Kaitoukid93/Ambino-Fan-HUB/Packaging/Huong dan lap dat.pdf

# 1 Kết Nối Fan

Hướng dẫn này chỉ áp dụng cho sản phẩm Ambino FAN HUB
Các hình dạng và thành phần của sản phẩm có thể thay đổi mà không báo trước

Cắm lần lượt các Fan vào vị trí các cổng theo số bên dưới. Fan không cần cắm theo thứ tự nhưng nếu các bạn nhớ được thứ tự Fan thì sẽ tốt hơn trong việc căn chỉnh hiệu ứng

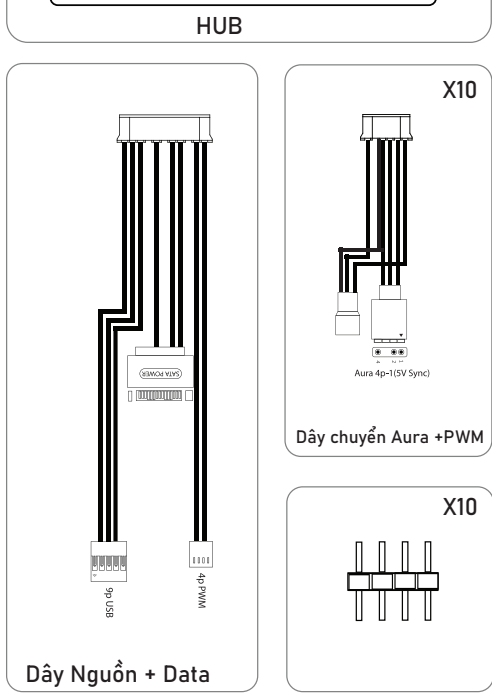
[picture p1: figure]
HUB; Dây Nguồn + Data; Dây chuyển Aura +PWM

Đối với các Fan sử dụng cổng Aura 5V và cổng PWM thì các bạn cần cắm qua dây chuyển trước rồi sau đó mới cắm vào hub

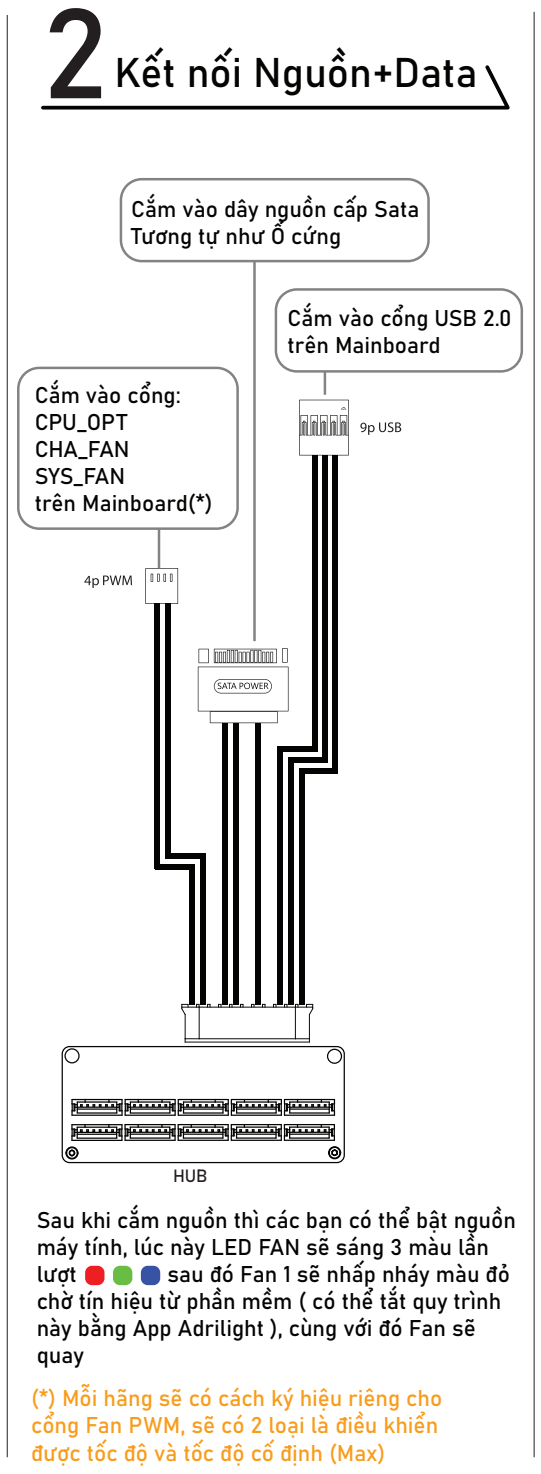
[picture p2: figure]
lượt; sau đó Fan 1 sẽ nhấp nháy màu đỏ; quay; Cắm vào dây nguồn cấp Sata Tương tự như Ổ cứng; Cắm vào cổng USB 2.0 trên Mainboard; Cắm vào cổng: CPU_OPT CHA_FAN SYS_FAN trên Mainboard(*); được tốc độ và tốc độ cố định (Max); 2 Kết nối Nguồn+Data; HUB

Sau khi cắm nguồn thì các bạn có thể bật nguồn máy tính, lúc này LED FAN sẽ sáng 3 màu lần chờ tín hiệu từ phần mềm ( có thể tắt quy trình này bằng App Adrilight ), cùng với đó Fan sẽ

(*) Mỗi hãng sẽ có cách ký hiệu riêng cho cổng Fan PWM, sẽ có 2 loại là điều khiển

# Hướng dẫn sử dụng

1 | 3 | 5 | 7 | 9
2 | 4 | 6 | 8 | 10

Dây chuyển Aura +PWM

Dây chuyển (nếu có)

Fan1 | Fan10

Truy cập Website http://ambino.vn để tải phần mềm.

0976.08.03.06

# 3Cài đặt phần mềm

DOWNLOAD

Double click file Setup.exe để cài đặt.

Chọn để thêm sản phẩm

Chọn sản phẩm Ambino Fan Hub

Chọn thông số rồi nhấn Finish

Click vào thẻ để
điều chỉnh các hiệu
ứng theo ý muốn

Nút này sẽ tự động
bật xanh

Thêm mới

Dashboard

Ambino Fan Hub
COM3
Device ID : 1
Độ sáng : 80%

Ẩn
