Kaitoukid93/Ambino-Fan-HUB/2D Resource/Untitled.dxf

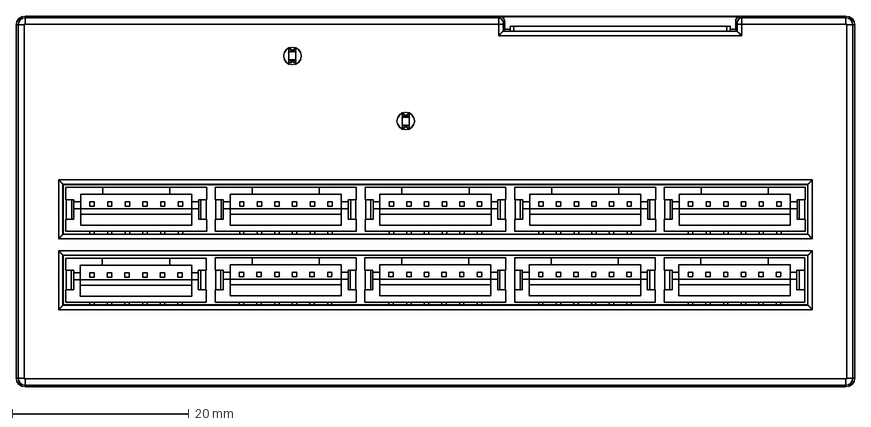
[picture p3: CAD file, 2022-07-25]
2D Resource/Untitled.dxf
95.0 x 42.0 mm
