Kaitoukid93/Ambino-Fan-HUB/Hardware/Ambino Fan HUB CH552G(Developer Only) rev2 dual core/exported outline.dxf

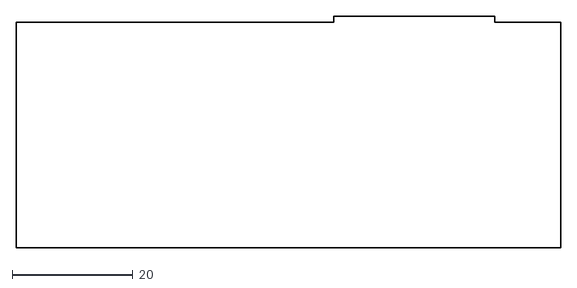
[picture p4: CAD file, 2022-01-03]
Hardware/Ambino Fan HUB CH552G(Developer Only) rev2 dual core/exported outline.dxf
90.2 x 38.4
