Kaitoukid93/Ambino-Fan-HUB/2D Resource/finished enclosure.dxf

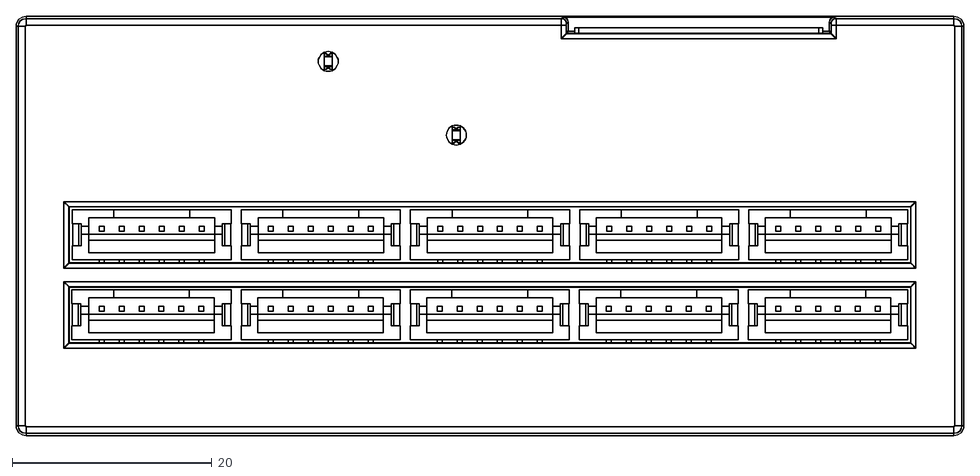
[picture p5: CAD file, 2022-07-25]
2D Resource/finished enclosure.dxf
95.0 x 42.0
