Kaitoukid93/Ambino-Fan-HUB/Hardware/Ambino Fan HUB CH552G(Developer Only) rev2 dual core/fanhub freecad.FCStd

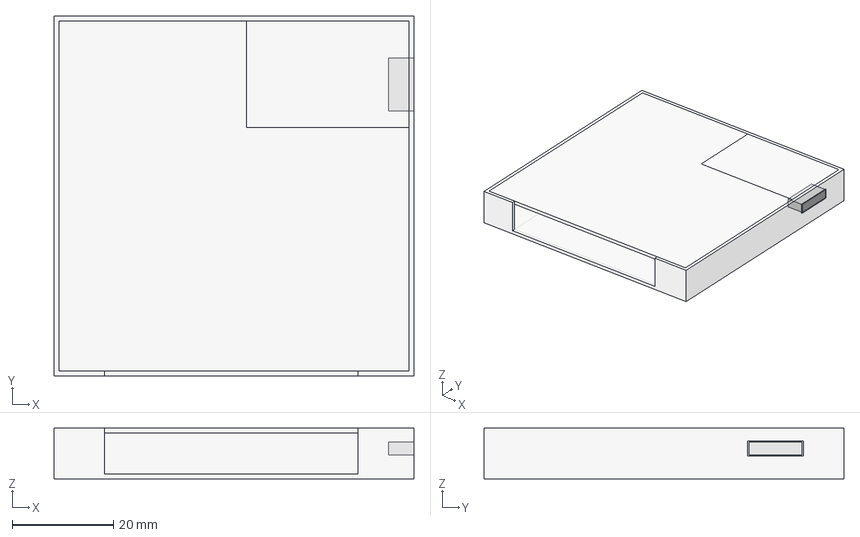
[picture p6: CAD file, 2021-12-10]
Hardware/Ambino Fan HUB CH552G(Developer Only) rev2 dual core/fanhub freecad.FCStd
71.0 x 71.0 x 10.0 mm
