Kaitoukid93/Ambino-Fan-HUB/2D Resource/outline.dxf

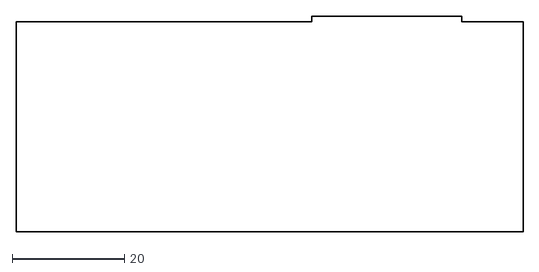
[picture p7: CAD file, 2022-01-03]
2D Resource/outline.dxf
90.2 x 38.4
