Kaitoukid93/Ambino-Fan-HUB/Hardware/Ambino Fan HUB CH552G(Developer Only) rev2 dual core/demo2.FCStd

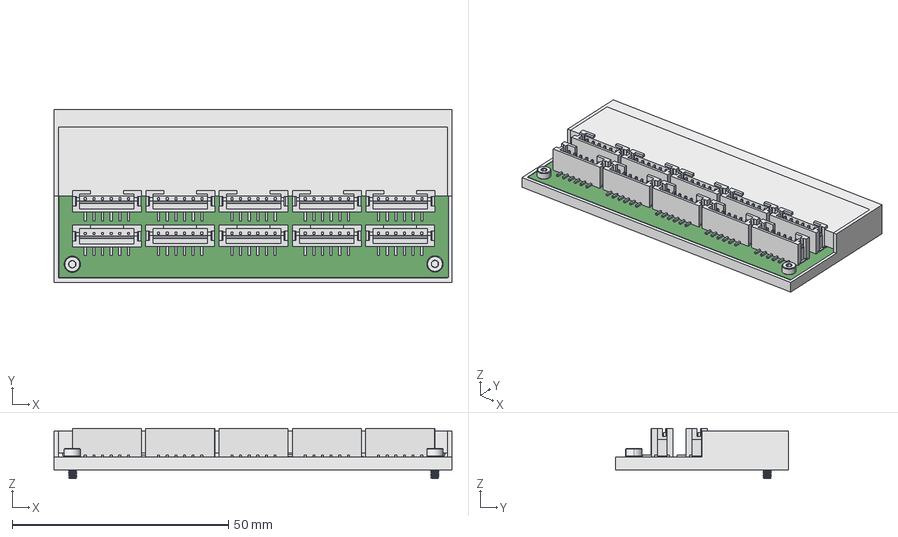
[picture p8: CAD file, 2021-12-10]
Hardware/Ambino Fan HUB CH552G(Developer Only) rev2 dual core/demo2.FCStd
92.0 x 40.0 x 11.6 mm
