Kaitoukid93/Ambino-Fan-HUB/2D Resource/drawing.dxf

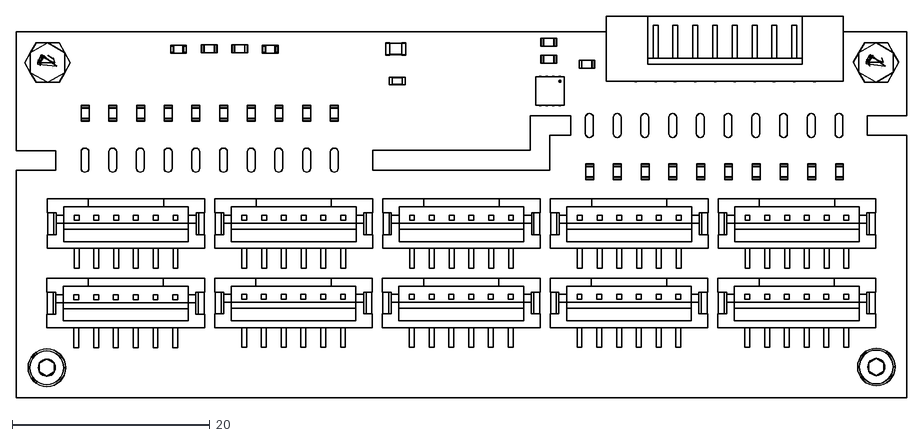
[picture p9: CAD file, 2021-12-31]
2D Resource/drawing.dxf
90.0 x 38.6
