Kaitoukid93/Ambino-Fan-HUB/2D Resource/PH6.dxf

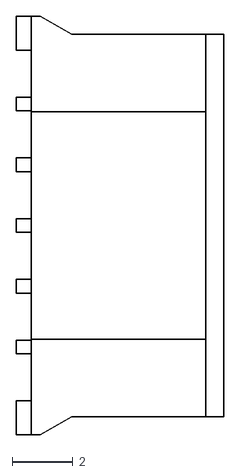
[picture p10: CAD file, 2021-12-10]
2D Resource/PH6.dxf
6.85 x 13.8
