Kaitoukid93/Ambino-Fan-HUB/2D Resource/PH11.dxf

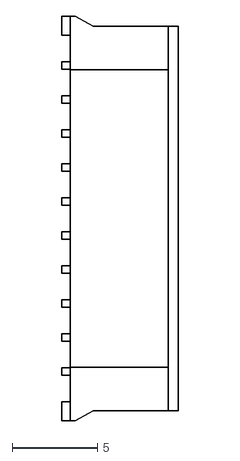
[picture p11: CAD file, 2021-12-10]
2D Resource/PH11.dxf
6.85 x 23.8
