Kaitoukid93/Ambino-Fan-HUB/Hardware/Wire and Connector/Ambino Fan HUB All wire_Fix_PWM.pdf

# Power +USB+PWM cord

# Ambino Fan HUB

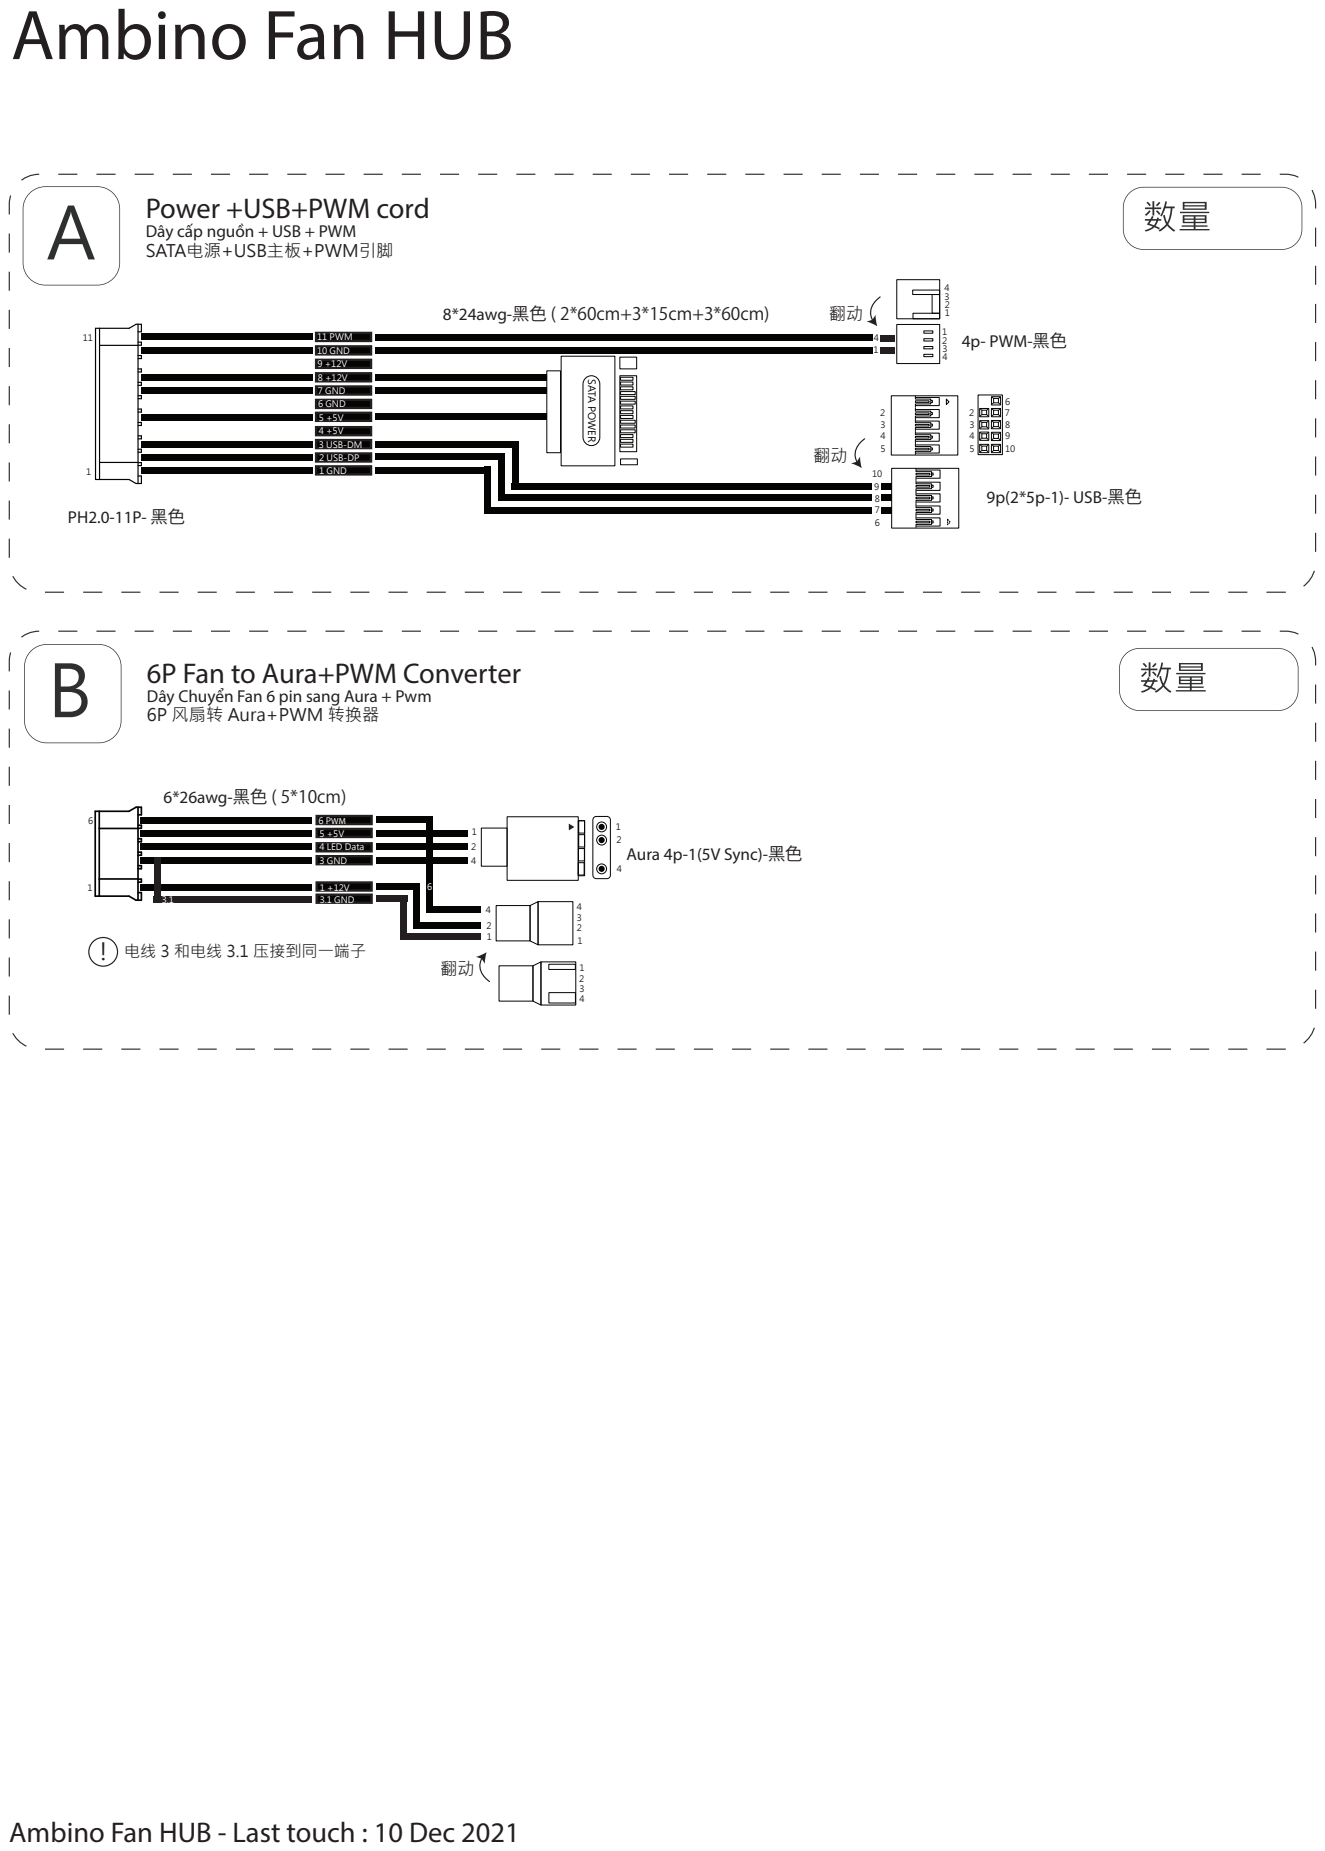
[picture p12: page 1]
10 GND; 4p- PWM-黑色; 8*24awg-黑色 ( 2*60cm+3*15cm+3*60cm); 6*26awg-黑色 ( 5*10cm); Aura 4p-1(5V Sync)-黑色; 9p(2*5p-1)- USB-黑色; 1 GND; 2 USB-DP; 3 USB-DM; 6 GND; 7 GND; 11 PWM; 1 +12V 3.1 GND; 3 GND; 4 LED Data; 6 PWM; SATA POWER

Dây cấp nguồn + USB + PWM
SATA电源+USB主板+PWM引脚

6P Fan to Aura+PWM Converter
Dây Chuyển Fan 6 pin sang Aura + Pwm
6P 风扇转 Aura+PWM 转换器

! 电线 3 和电线 3.1 压接到同一端子

Ambino Fan HUB - Last touch : 10 Dec 2021
