Kaitoukid93/Ambino-Fan-HUB/Packaging/file in tem ambino fan HUB.pdf

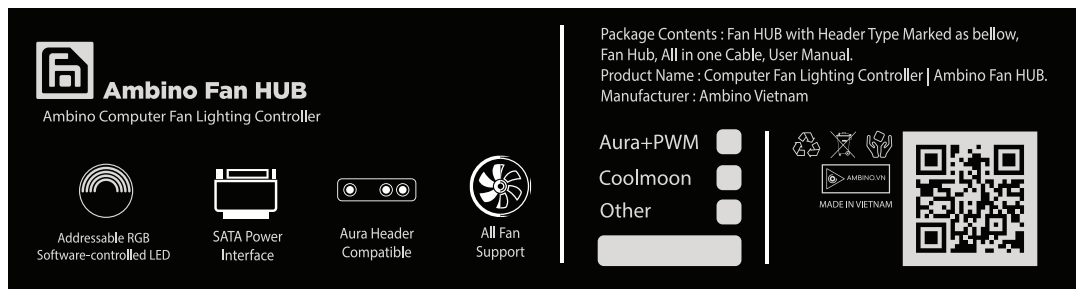
[picture p13: page 1]
