Kaitoukid93/Ambino-Fan-HUB/Hardware/CH552G dualcore/Ambino Fan HUB CH552G.kicad_pcb

## KiCad design Hardware/CH552G dualcore/Ambino Fan HUB CH552G.kicad_pcb (2022-07-25)

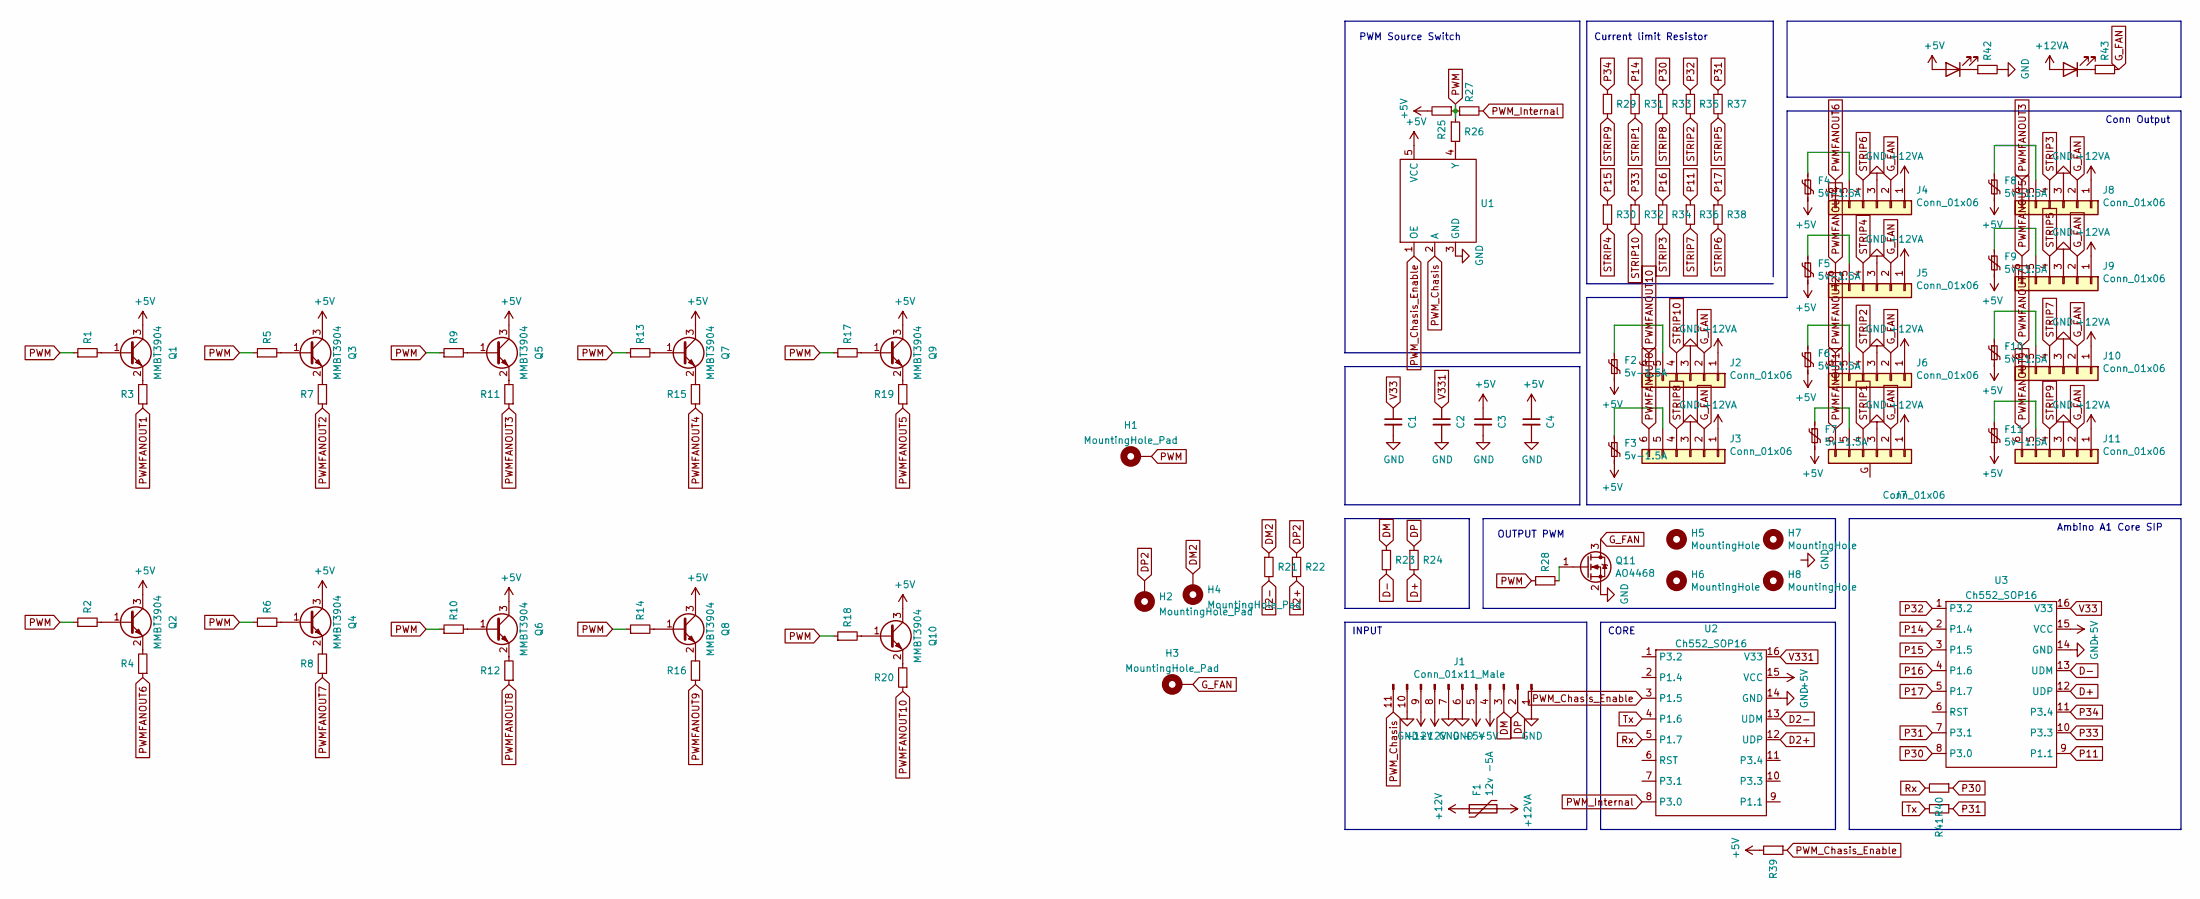
[picture p17: schematic Ambino Fan HUB CH552G.kicad_sch]

Parts:
C1, C2: 104; C_0603_1608Metric
C3, C4: 106; C_0603_1608Metric
D1: LED_BLUE; LED_0603_1608Metric
D2: LED_GREEN; LED_0603_1608Metric
F1: 12v -5A; Fuse_1206_3216Metric
F2, F3, F4, F5, F6, F7, F8, F9, F10, F11: 5v-1.5A; Fuse_0603_1608Metric
H1, H2, H3, H4: MountingHole_Pad; MountingHole_2.2mm_M2_DIN965_Pad
H5, H6, H7, H8: MountingHole; Mounting_Wuerth_WA-SMSI-M2_H1.5mm_9774015243
J1: Conn_01x11_Male; JST_PH_S11B-PH-SM4-TB_1x11-1MP_P2.00mm_Horizontal
J2, J3, J4, J5, J6, J7, J8, J9, J10, J11: Conn_01x06; JST_PH_B6B-PH-K_1x06_P2.00mm_Vertical
Q1, Q2, Q3, Q4, Q5, Q6, Q7, Q8, Q9, Q10: MMBT3904; SOT-23
Q11: AO4468; SOP-8_3.9x4.9mm_P1.27mm
R1, R2, R5, R6, R9, R10, R13, R14, R17, R18, R26, R27, R28: 150R; R_0603_1608Metric
R3, R4, R7, R8, R11, R12, R15, R16, R19, R20, R29, R30, R31, R32, R33, R34, R35, R36, R37, R38, R40, R41: 220R; R_0603_1608Metric
R21, R22, R23, R24: 33R; R_0603_1608Metric
R25, R39: 10k; R_0603_1608Metric
R42: 330R; R_0603_1608Metric
R43: 1K; R_0603_1608Metric
U1: SN74AHC1G125DBVR; SOT-23-5
U2, U3: Ch552_SOP16; SOP-16_3.9x9.9mm_P1.27mm

Connections:
+5V: C3.1, C4.1, D1.2 (A), F2.2, F3.2, F4.2, F5.2, F6.2, F7.2, F8.2, F9.2, F10.2, F11.2, J1.4, J1.5, Q1.3 (C), Q2.3 (C), Q3.3 (C), Q4.3 (C), Q5.3 (C), Q6.3 (C), Q7.3 (C), Q8.3 (C), Q9.3 (C), Q10.3 (C), R25.2, R39.2, U1.5 (VCC), U2.15 (VCC), U3.15 (VCC)
+12V: F1.1, J1.8, J1.9
+12VA: D2.2 (A), F1.2, J2.1, J3.1, J4.1, J5.1, J6.1, J7.1, J8.1, J9.1, J10.1, J11.1
D2+: R22.2, U2.12 (UDP)
D2-: R21.2, U2.13 (UDM)
D+: R24.2, U3.12 (UDP)
D-: R23.2, U3.13 (UDM)
DM: J1.3, R23.1
DM2: H4.1, R21.1; also elsewhere on the board
DP: J1.2, R24.1
DP2: H2.1, R22.1; also elsewhere on the board
GND: C1.2, C2.2, C3.2, C4.2, J1.1, J1.6, J1.7, J1.10, J2.3, J3.3, J4.3, J5.3, J6.3, J7.3, J8.3, J9.3, J10.3, J11.3, Q11.2 (S), R42.2, U1.3 (GND), U2.14 (GND), U3.14 (GND)
G_FAN: H3.1, J2.2, J3.2, J4.2, J5.2, J6.2, J7.2, J8.2, J9.2, J10.2, J11.2, Q11.3 (D), R43.2; also elsewhere on the board
unnamed: D1.1 (K), R42.1
unnamed: D2.1 (K), R43.1
unnamed: F2.1, J2.5
unnamed: F3.1, J3.5
unnamed: F4.1, J4.5
unnamed: F5.1, J5.5
unnamed: F6.1, J6.5
unnamed: F7.1, J7.5
unnamed: F8.1, J8.5
unnamed: F9.1, J9.5
unnamed: F10.1, J10.5
unnamed: F11.1, J11.5
unnamed: Q1.1 (B), R1.2
unnamed: Q1.2 (E), R3.2
unnamed: Q2.1 (B), R2.2
unnamed: Q2.2 (E), R4.2
unnamed: Q3.1 (B), R5.2
unnamed: Q3.2 (E), R7.2
unnamed: Q4.1 (B), R6.2
unnamed: Q4.2 (E), R8.2
unnamed: Q5.1 (B), R9.2
unnamed: Q5.2 (E), R11.2
unnamed: Q6.1 (B), R10.2
unnamed: Q6.2 (E), R12.2
unnamed: Q7.1 (B), R13.2
unnamed: Q7.2 (E), R15.2
unnamed: Q8.1 (B), R14.2
unnamed: Q8.2 (E), R16.2
unnamed: Q9.1 (B), R17.2
unnamed: Q9.2 (E), R19.2
unnamed: Q10.1 (B), R18.2
unnamed: Q10.2 (E), R20.2
unnamed: Q11.1 (G), R28.2
unnamed: R26.2, U1.4 (Y)
P11: R36.1, U3.9 (P1.1)
P14: R31.1, U3.2 (P1.4)
P15: R30.1, U3.3 (P1.5)
P16: R34.1, U3.4 (P1.6)
P17: R38.1, U3.5 (P1.7)
P30: R33.1, R40.1, U3.8 (P3.0)
P31: R37.1, R41.1, U3.7 (P3.1)
P32: R35.1, U3.1 (P3.2)
P33: R32.1, U3.10 (P3.3)
P34: R29.1, U3.11 (P3.4)
PWM: H1.1, R1.1, R2.1, R5.1, R6.1, R9.1, R10.1, R13.1, R14.1, R17.1, R18.1, R25.1, R26.1, R27.1, R28.1; also elsewhere on the board
PWMFANOUT1: J7.6, R3.1
PWMFANOUT2: J6.6, R7.1
PWMFANOUT3: J8.6, R11.1
PWMFANOUT4: J5.6, R15.1
PWMFANOUT5: J9.6, R19.1
PWMFANOUT6: J4.6, R4.1
PWMFANOUT7: J10.6, R8.1
PWMFANOUT8: J3.6, R12.1
PWMFANOUT9: J11.6, R16.1
PWMFANOUT10: J2.6, R20.1
PWM_Chasis: J1.11, U1.2 (A)
PWM_Chasis_Enable: R39.1, U1.1 (OE), U2.3 (P1.5)
PWM_Internal: R27.2, U2.8 (P3.0)
Rx: R40.2, U2.5 (P1.7)
STRIP1: J7.4, R31.2
STRIP2: J6.4, R35.2
STRIP3: J8.4, R34.2
STRIP4: J5.4, R30.2
STRIP5: J9.4, R37.2
STRIP6: J4.4, R38.2
STRIP7: J10.4, R36.2
STRIP8: J3.4, R33.2
STRIP9: J11.4, R29.2
STRIP10: J2.4, R32.2
Tx: R41.2, U2.4 (P1.6)
V33: C1.1, U3.16 (V33)
V331: C2.1, U2.16 (V33)

Notes on the sheet:
Conn Output
Ambino A1 Core SIP
OUTPUT PWM
Current limit Resistor
CORE
INPUT
PWM Source Switch

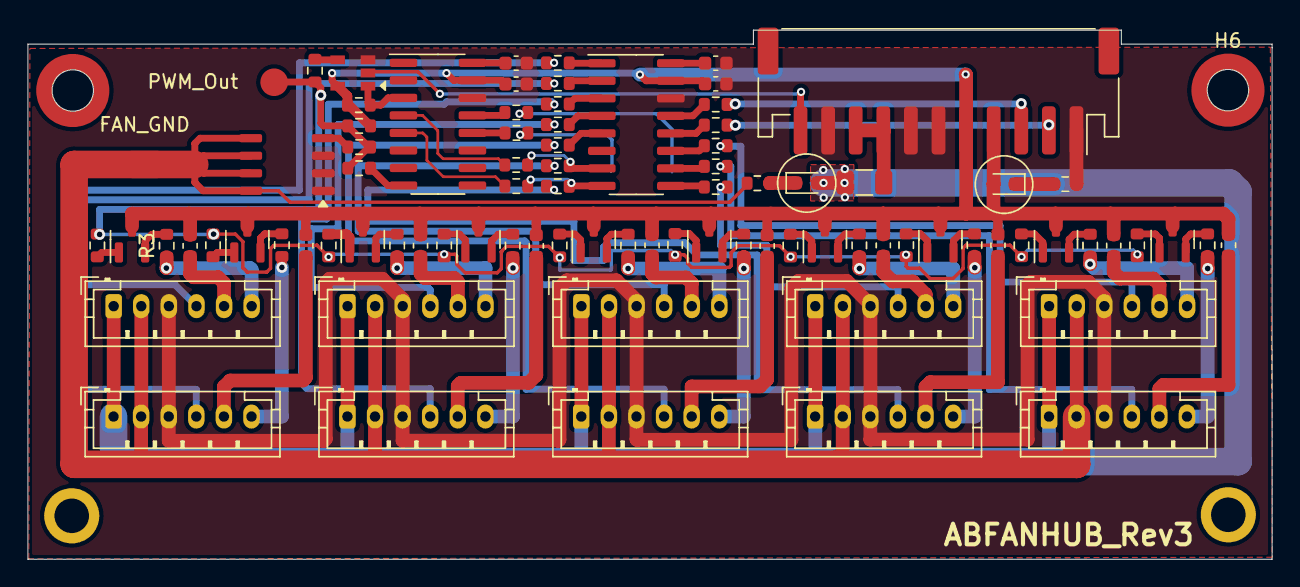
[picture p18: board Hardware/CH552G dualcore/Ambino Fan HUB CH552G.kicad_pcb from above]

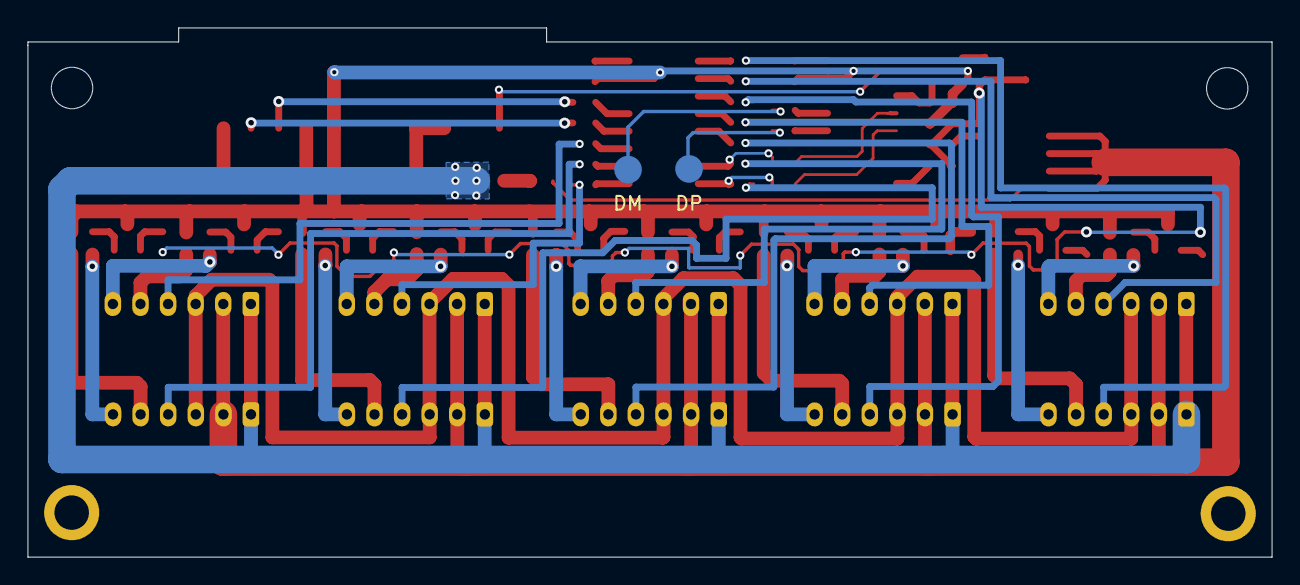
[picture p19: board Hardware/CH552G dualcore/Ambino Fan HUB CH552G.kicad_pcb from below]

Board: 2 copper layers, 90.2 x 38.4 mm, 93 parts (2 on the bottom side), 85 nets.

Other parts of the board:
DM: MountingHole_Pad; MountingHole_2.2mm_M2_DIN965_Pad
DP: MountingHole_Pad; MountingHole_2.2mm_M2_DIN965_Pad
FAN_GND: MountingHole_Pad; MountingHole_2.2mm_M2_DIN965_Pad
PWM_Out: MountingHole_Pad; MountingHole_2.2mm_M2_DIN965_Pad

Their connections:
DM2: DM.1; also elsewhere on the board
DP2: DP.1; also elsewhere on the board
G_FAN: FAN_GND.1; also elsewhere on the board
PWM: PWM_Out.1; also elsewhere on the board
