Kaitoukid93/Ambino-Fan-HUB/Hardware/Ambino Fan HUB CH552G(Developer Only) rev2 dual core/Ambino Fan HUB CH552G.kicad_pcb

## KiCad design Hardware/Ambino Fan HUB CH552G(Developer Only) rev2 dual core/Ambino Fan HUB CH552G.kicad_pcb (2022-01-03)

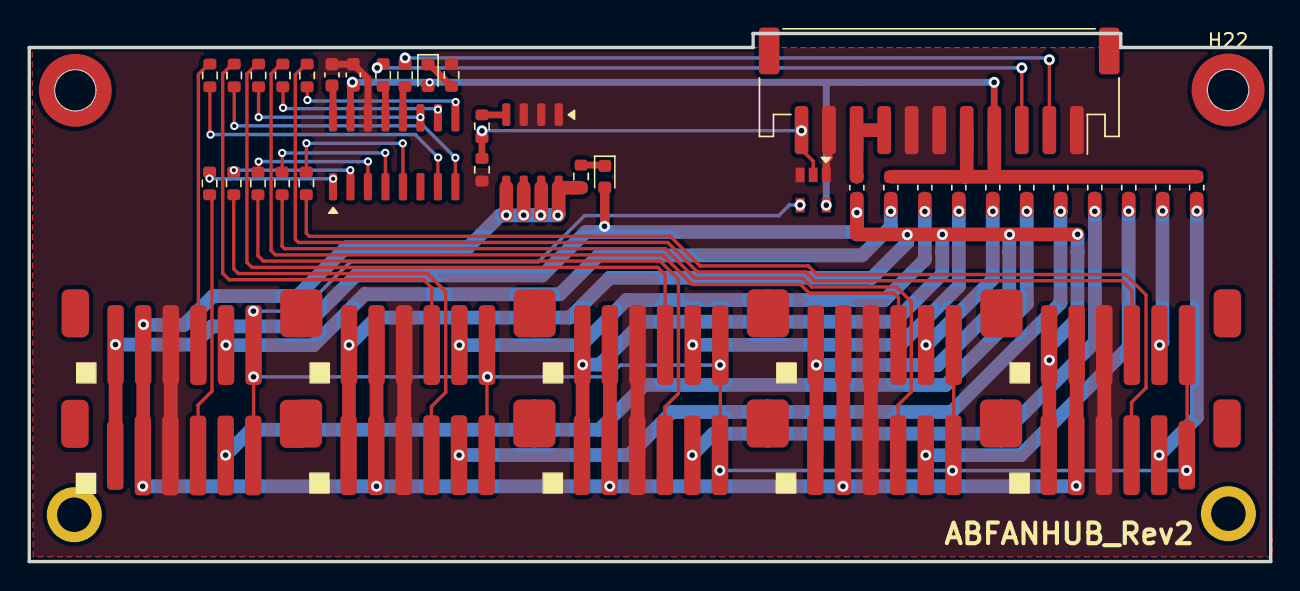
[picture p20: board Hardware/Ambino Fan HUB CH552G(Developer Only) rev2 dual core/Ambino … from above]

Board: 2 copper layers, 90.2 x 38.4 mm, 49 parts (0 on the bottom side), 45 nets.

Parts:
C6: 104; C_0603_1608Metric
C7: 106; C_0603_1608Metric
D3: LED_BLUE; LED_0603_1608Metric
D4: LED_GREEN; LED_0603_1608Metric
F1, F2, F3, F4, F5, F6, F7, F8, F9, F10: 5v-1.5A; Fuse_0603_1608Metric
F11: 12v -5A; Fuse_0603_1608Metric
H21, H22, H23, H24: MountingHole; Mounting_Wuerth_WA-SMSI-M2_H1.5mm_9774015243
J1: https://item.taobao.com/item.htm?spm=a230r.1.14.2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; JST_PH_S11B-PH-SM4-TB_1x11-1MP_P2.00mm_Horizontal
J5, J6, J7, J8, J9, J10, J11, J12, J13, J14: Conn_01x06; JST_PH_B6B-PH-K_1x06_P2.00mm_Vertical
Q1: AO4468; SOP-8_3.9x4.9mm_P1.27mm
R1, R17, R18: 33R; R_0603_1608Metric
R2: 10K; R_0603_1608Metric
R7, R8, R9, R10, R11, R12, R13, R14, R15, R16: 220R; R_0603_1608Metric
R20: 330R; R_0603_1608Metric
R21: 1K; R_0603_1608Metric
U1: Ch552_SOP16; SOP-16_3.9x9.9mm_P1.27mm
U2: SN74AHC1G125DBVR; SOT-23-5

Connections:
+5V: C7.1, D3.2 (A), F1.2, F2.2, F3.2, F4.2, F5.2, F6.2, F7.2, F8.2, F9.2, F10.2, J1.4, J1.5, U1.15 (VCC), U2.5 (Y)
+12V: F11.1, J1.8, J1.9
+12VA: D4.2 (A), F11.2, J5.1, J6.1, J7.1, J8.1, J9.1, J10.1, J11.1, J12.1, J13.1, J14.1
D+: R18.2, U1.12 (UDP)
D-: R17.2, U1.13 (UDM)
DM: J1.3, R17.1
DP: J1.2, R18.1
GND: C6.2, C7.2, J1.1, J1.6, J1.7, J1.10, J5.3, J6.3, J7.3, J8.3, J9.3, J10.3, J11.3, J12.3, J13.3, J14.3, Q1.2 (S), R2.2, R20.2, U1.14 (GND), U2.1 (OE), U2.3 (GND)
G_FAN: J5.2, J6.2, J7.2, J8.2, J9.2, J10.2, J11.2, J12.2, J13.2, J14.2, Q1.3 (D), R21.2
unnamed: D3.1 (K), R20.1
unnamed: D4.1 (K), R21.1
unnamed: F1.1, J5.5
unnamed: F2.1, J6.5
unnamed: F3.1, J7.5
unnamed: F4.1, J8.5
unnamed: F5.1, J9.5
unnamed: F6.1, J10.5
unnamed: F7.1, J11.5
unnamed: F8.1, J12.5
unnamed: F9.1, J13.5
unnamed: F10.1, J14.5
P11: R14.1, U1.9 (P1.1)
P14: R9.1, U1.2 (P1.4)
P15: R8.1, U1.3 (P1.5)
P16: R12.1, U1.4 (P1.6)
P17: R16.1, U1.5 (P1.7)
P30: R11.1, U1.8 (P3.0)
P31: R15.1, U1.7 (P3.1)
P32: R13.1, U1.1 (P3.2)
P33: R10.1, U1.10 (P3.3)
P34: R7.1, U1.11 (P3.4)
PWM_Chasis: J1.11, R1.1, R2.1, U2.2 (A)
PWM_Chasis_OUT: J5.6, J6.6, J7.6, J8.6, J10.6, J11.6, J12.6, J13.6, J14.6, U2.4 (VCC)
PWM_Out: Q1.1 (G), R1.2
STRIP1: J10.4, R15.2
STRIP2: J9.4, R13.2
STRIP3: J11.4, R11.2
STRIP4: J8.4, R9.2
STRIP5: J12.4, R7.2
STRIP6: J7.4, R8.2
STRIP7: J13.4, R10.2
STRIP8: J6.4, R12.2
STRIP9: J14.4, R14.2
STRIP10: J5.4, R16.2
V33: C6.1, U1.16 (V33)
