Kaitoukid93/Ambino-Fan-HUB/(commit log)

2021-12-08 change how data is sent and received on hub object support 1000 leds with only 1 kbyte of ram
2021-12-10 Hardware and firmware development init
    [Ambino Fan HUB CH552G.kicad_pcb, Ambino Fan HUB CH552G.sch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]
2021-12-10 Add 3D files
    [Ambino Fan HUB CH552G.kicad_pcb, Ambino Fan HUB CH552G.sch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]
2021-12-27 fix 74hc pin
    [Ambino Fan HUB CH552G_Pannelize-B_Cu.gbl, Ambino Fan HUB CH552G_Pannelize-B_Mask.gbs, Ambino Fan HUB CH552G_Pannelize-B_Paste.gbp, Ambino Fan HUB CH552G_Pannelize-B_Silkscreen.gbo, Ambino Fan HUB CH552G_Pannelize-Edge_Cuts.gm1, Ambino Fan HUB CH552G_Pannelize-F_Cu.gtl, Ambino Fan HUB CH552G_Pannelize-F_Mask.gts, Ambino Fan HUB CH552G_Pannelize-F_Paste.gtp]
2021-12-31 add support file and user manual
    [Ambino Fan HUB CH552G_Pannelize.kicad_pcb, drawing.dxf]
2022-01-03 update 3d file
    [Ambino Fan HUB CH552G.kicad_pcb, exported outline.dxf, outline.dxf]
2022-02-22 fix pwm pin(wire and connector)
2022-07-25 update dualcore
    [Ambino Fan HUB CH552G.kicad_pcb, Ambino Fan HUB CH552G.kicad_sch, Ambino Fan HUB CH552G.sch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]
